eltsu7/lightsensor/(commit log)

2026-06-07 Speed up sampling, rework GUI scaling/sidebar, add v2 notes
    - Firmware: 115200 baud + 860 SPS data rate (~177 samples/s, up from ~90)
    - Driver/GUI: match new baud rate
    - GUI: detect user pan/zoom to drop follow/autoscale; add Follow latest
    checkbox; stats over visible window; remove buffer-clear on scale toggle
    - GUI: move controls into grouped right sidebar
    - Add test_read.py smoke test, ADS1115 breakout datasheet, TODO_v2.md
    [lightsensor.ino, lightsensor.py, main.py, test_read.py]
2026-06-19 Add on-device calibration storage (LittleFS)
    Store a spectral responsivity CSV + metadata on the ESP32-C3 flash via
    LittleFS. New serial commands W/C/H/X (CRC32-verified chunked transfer)
    and driver methods write/read/has/clear_calibration. Includes dummy data.
    [calibration_dummy.csv]
2026-06-19 Finish ESP32-C3 migration cleanup and GUI work
    Collapse justfile to the single ESP32-C3 target (auto-detected port),
    remove the duplicate lightsensor_esp32 sketch and stale ESP8266
    datasheets, add port_detect.py, ignore recordings/, and extend the
    debug GUI. Add JHD162A screen notes.
2026-06-19 Add device identity handshake, error codes, and resync
    New I command reports product/proto/fw/unique-id for a connect-time
    handshake (LightSensor.info), with a protocol-version check. Bare 'err'
    responses now carry a documented code. Driver resyncs a desynced stream
    by going silent past the device's receive timeout rather than pinging
    (which would feed a pending W and keep it alive); recovery preserves
    stored calibration. Adds module logging for command failures.
    [lightsensor.ino, lightsensor.py]
2026-06-19 Add volts-to-physical-units conversion pipeline
    Calibration gains a pure, host-side conversion layer: responsivity_at
    (interpolation), source_weighted_responsivity (trapezoidal spectral
    weighting), and voltage_to_value implementing physical = scale_factor *
    V / R_bar_source. LightSensor caches the calibration and adds
    read_physical(source=None) and reading_voltage(). source=None gives the
    uncorrected value; passing a source spectrum applies spectral correction.
    scale_factor and R(lambda) are still placeholders pending a reference
    measurement and monochromator sweep; the pipeline is unit-tested
    (test_calibration.py, 8 cases, no hardware) and verified end-to-end.
    [lightsensor.py, test_calibration.py]
2026-06-19 Make driver thread-safe with reconnect support
    Guard every serial transaction with a re-entrant lock so a LightSensor
    can be shared across threads. Add connected property, reconnect() (re-
    detects the port since the device can re-enumerate after a replug), and
    an opt-in auto_reconnect flag that lets read() recover transparently
    instead of raising (off by default, so callers with their own reconnect
    loop like main.py are unchanged). Split read() into a locked _read_raw
    transaction and log timeouts/parse errors instead of silently dropping.
    [lightsensor.py]
2026-06-19 Report gain table and saturation voltage in identity
    Firmware is the source of truth for the gain voltages and sensor
    saturation threshold; it now emits them in the I identity line. The
    driver verifies its mirrored GAIN_VOLTAGES / SATURATION_VOLTAGE against
    the device on connect and warns on drift, catching a firmware/driver
    mismatch at handshake time.
    [lightsensor.ino, lightsensor.py]
2026-06-19 Make the project pip-installable with a GUI entry point
    Add a hatchling build backend including the flat modules, a lightmeter
    console script (launches the debug GUI), a real description, and a brief
    README. uv build produces a working wheel.
2026-06-19 Restructure into a package: lightmeter/, firmware/, tests/, data/
    Move the flat modules into a lightmeter/ package (sensor.py, gui.py,
    port_detect.py) with an __init__ that re-exports the public API; move
    the sketch under firmware/, tests under tests/, and the dummy
    calibration under data/. Update imports, the justfile paths, the GUI
    entry point (lightmeter.gui:main), and doc paths. Drop the now-unused
    hatch include list (the package is auto-detected) and a stale unused
    import. Builds, unit tests, lint, and firmware compile all pass.
    [calibration_dummy.csv]
2026-06-19 Prune TODO to open items; rename TODO_v2.md -> TODO.md
    The v2 migration (ESP32-C3, integrated ADC) is shipped. Trim the file to
    what's actually open: calibration, thermal drift, the ALERT/RDY sample-
    rate path, and optional follow-ups.
2026-06-19 Consolidate docs into CLAUDE.md; reduce AGENTS.md to a pointer
    CLAUDE.md is now the single authoritative project doc (overview,
    commands, architecture, hardware, serial protocol, calibration model).
    AGENTS.md becomes a pointer for tools that look for it; the volatile
    per-control GUI tables and full driver member list are left to the code.
    Update README/TODO references.
2026-06-19 Move protocol/API reference to docs/reference.md; drop AGENTS.md
    CLAUDE.md is trimmed to high-level orientation (overview, commands,
    architecture, invariants, hardware gotchas) and points to the new
    docs/reference.md for the serial protocol, driver API, and calibration
    model. Delete AGENTS.md entirely; repoint README.
2026-06-20 Add BPW34 datasheet-typical default calibration + daylight W/m² GUI mode
    Bundle a nominal fallback calibration so readings have a real spectral shape
    and a ballpark absolute scale out of the box, clearly flagged as datasheet-only:
    - lightmeter/data/calibration_bpw34_typical.csv: R(λ) digitized from the Vishay
    BPW34 datasheet (Fig. 7, peak 900 nm, 10% points 430/1100 nm) plus a nominal
    scale_factor = 1/(R_peak·A·R_f) ≈ 0.103 W/m²/V (R_peak≈0.646 A/W from the
    I_k spec point, A=7.5 mm², board R_f=2 MΩ). Ships in the wheel.
    - Calibration.provenance / is_nominal: distinguishes 'measured' from
    'datasheet-typical' so a nominal cal is never mistaken for a real one.
    - default_cali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
    [calibration_bpw34_typical.csv]
2026-06-20 Add lux units mode (photopic-weighted illuminance) to the GUI
    - sensor.py: embed the CIE photopic V(λ) curve (PHOTOPIC_V, 380–780 nm) and add
    luminous_efficacy(source) -> K = 683·V̄ (lm/W). Illuminance = K · irradiance.
    - gui.py: add "lux" to the units selector; lux factor = the daylight W/m²-per-volt
    factor × K(daylight) ≈ 30 lux/V. Lux is the honest photometric unit for a flat
    detector (luminance/cd/m² would need a solid-angle assumption, so it's left out).
    - Reuses Calibration's trapezoidal source-weighting for V̄. Tests for the efficacy
    and the volts→lux path (14 passing). reference.md documents the photometric path.
2026-07-06 Add Rust driver; move autogain from host to firmware (proto 2)
    New rust/ crate (lightmeter): a from-scratch Rust port of sensor.py for
    the pointcamera turret rig, behind a Transport trait with a SimTransport
    that emulates the firmware line-by-line for hardware-free tests/GUIs.
    Calibration transfer and physical-unit conversion are not ported yet.
    Firmware (proto 1 -> 2): autogain (autoexposure) moves from both host
    drivers into lightsensor.ino. New commands a0/a1 (enable/disable) and A
    (query state + gain), matching the g/G setter/getter casing. r<n> now
    autoexposes first when enabled -- read a sample, step gain on over-
    (saturated or >=90% fs) or under-exposure (<40%), re-read, until in-ban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
2026-07-06 Fix stale protocol-v1 references left over from the proto-2 migration
    Cargo.toml description, three module-level doc comments (lib.rs,
    sensor.rs, tests/sensor.rs), parse_identity's own doc example, and the
    matching Python docstring example all still said proto=1/v1.
    [sensor.py]
2026-07-06 Pin driver package major version to the wire protocol version
    pyproject.toml and rust/Cargo.toml bump 0.1.0 -> 2.0.0 to match proto 2:
    lightmeter==2.* / lightmeter"2" is now a compatibility promise, not an
    arbitrary number. Each driver gets a test asserting its own package major
    equals PROTO_VERSION, so a future proto bump without the matching major
    bump (or vice versa) fails CI instead of shipping a silent mismatch.
    Convention going forward: PROTO_VERSION bumps to N -> both drivers bump
    to N.0.0; driver-only changes (bugfixes, new methods) are free to bump
    minor/patch as long as major stays pinned to the protocol they speak.
    [test_calibration.py]
2026-07-06 Write a proper README
    Was a 4-line stub. Now covers: features, hardware/wiring, repo layout,
    quick start for both drivers, the protocol at a glance, calibration
    status (accurate: shape is real Vishay-typical, scale is a datasheet
    estimate pending a reference measurement), dev/test commands, roadmap
    pointer, and an honest license statement (no repo-wide LICENSE file;
    only the Rust crate declares MIT OR Apache-2.0).
2026-07-17 Add persisted device dark offset
2026-07-17 Add persistent dark calibration control
2026-08-03 Implement LightSensor v3 stack
    [calibration_bpw34_typical.csv, calibration_dummy.csv]
